mattmonson/OpenSpace/logs/Compression Test/log.csv

time (ms) | temp (C) | pressure (Pa)
1036 | 24.0 | 101054
1320 | 24.0 | 101049
1607 | 24.0 | 101056
1894 | 24.0 | 101044
2179 | 24.0 | 101040
2465 | 24.0 | 101044
2752 | 24.0 | 101054
3037 | 24.0 | 101051
3323 | 24.0 | 101046
3610 | 24.0 | 101044
3895 | 24.0 | 101044
4182 | 24.0 | 101041
4468 | 24.0 | 101042
4753 | 24.0 | 101044
5040 | 24.0 | 101043
5324 | 24.0 | 101044
5611 | 24.0 | 101041
5898 | 24.0 | 101051
6182 | 24.0 | 101041
6469 | 24.0 | 101053
6756 | 24.0 | 101047
7041 | 24.0 | 101053
7327 | 24.0 | 101044
7614 | 24.0 | 101044
7899 | 24.0 | 101056
8185 | 24.0 | 101048
8472 | 24.0 | 101044
8757 | 24.0 | 101049
9043 | 24.0 | 101044
9330 | 24.0 | 101048
9615 | 24.0 | 101049
9902 | 24.0 | 101046
10188 | 24.0 | 101054
10473 | 24.0 | 101042
10760 | 24.0 | 101048
11046 | 24.0 | 101048
11331 | 24.0 | 101054
11618 | 24.0 | 101050
11905 | 24.0 | 101043
12191 | 24.0 | 101047
12476 | 24.0 | 101045
12763 | 24.0 | 101043
13049 | 24.0 | 101050
13334 | 24.0 | 101048
13621 | 24.0 | 101044
13907 | 24.0 | 101042
14194 | 24.0 | 101048
14479 | 24.1 | 101051
14766 | 24.0 | 101046
15052 | 24.0 | 101040
15337 | 24.0 | 101043
15624 | 24.0 | 101043
15910 | 24.0 | 101051
16197 | 24.0 | 101044
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
