mattmonson/OpenSpace/logs/Compression Test/log.xlsx

time (ms) | time (min) | circumference (in) | temp (˚C) | pressure (Pa)
1036 | 0.01726666667 | 0 | 24.0 | 101054
1320 | 0.022 |  | 24.0 | 101049
1607 | 0.02678333333 |  | 24.0 | 101056
1894 | 0.03156666667 |  | 24.0 | 101044
2179 | 0.03631666667 |  | 24.0 | 101040
2465 | 0.04108333333 |  | 24.0 | 101044
2752 | 0.04586666667 |  | 24.0 | 101054
3037 | 0.1 |  | 24.0 | 101051
3323 | 0.1 |  | 24.0 | 101046
3610 | 0.1 |  | 24.0 | 101044
3895 | 0.1 |  | 24.0 | 101044
4182 | 0.1 |  | 24.0 | 101041
4468 | 0.1 |  | 24.0 | 101042
4753 | 0.1 |  | 24.0 | 101044
5040 | 0.1 |  | 24.0 | 101043
5324 | 0.1 |  | 24.0 | 101044
5611 | 0.1 |  | 24.0 | 101041
5898 | 0.1 |  | 24.0 | 101051
6182 | 0.1 |  | 24.0 | 101041
6469 | 0.1 |  | 24.0 | 101053
6756 | 0.1 |  | 24.0 | 101047
7041 | 0.1 |  | 24.0 | 101053
7327 | 0.1 |  | 24.0 | 101044
7614 | 0.1 |  | 24.0 | 101044
7899 | 0.1 |  | 24.0 | 101056
8185 | 0.1 |  | 24.0 | 101048
8472 | 0.1 |  | 24.0 | 101044
8757 | 0.1 |  | 24.0 | 101049
9043 | 0.2 |  | 24.0 | 101044
9330 | 0.2 |  | 24.0 | 101048
9615 | 0.2 |  | 24.0 | 101049
9902 | 0.2 |  | 24.0 | 101046
10188 | 0.2 |  | 24.0 | 101054
10473 | 0.2 |  | 24.0 | 101042
10760 | 0.2 |  | 24.0 | 101048
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
