mattmonson/OpenSpace/boards/Power/TPS6300x/TPS6300x.brd

## EAGLE design boards/Power/TPS6300x/TPS6300x.brd (2012-06-09)

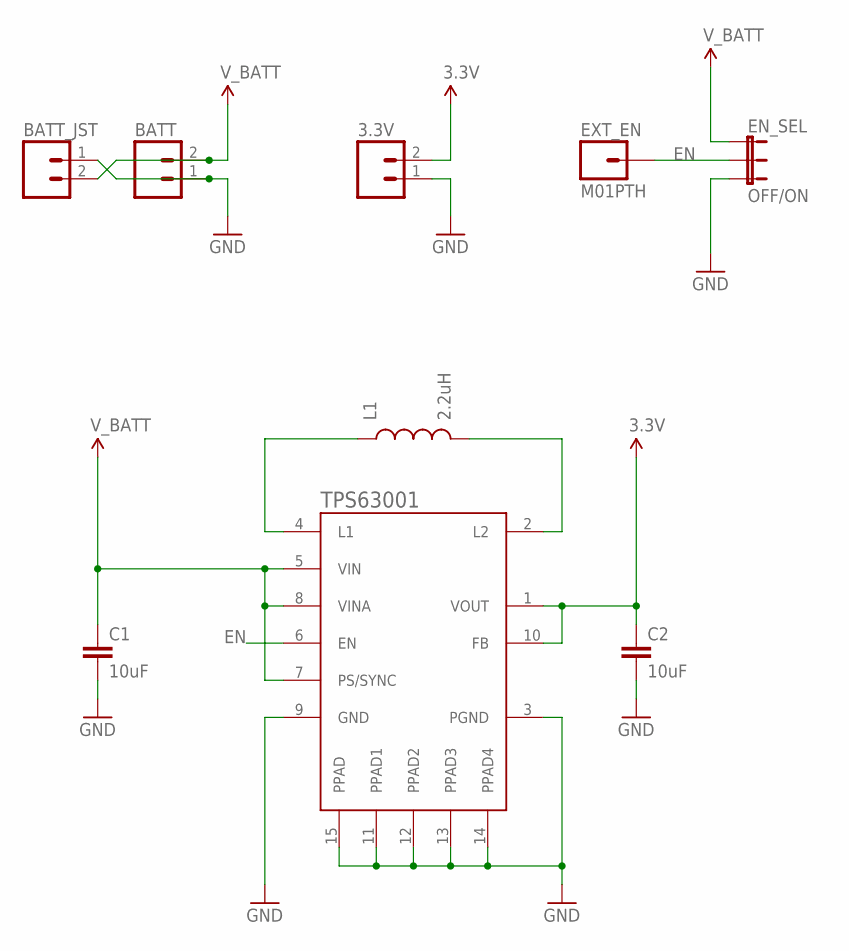
[picture p1: schematic TPS6300x.sch]

Parts:
3.3V: M02PTH; 1X02
BATT: M02PTH; 1X02
BATT_JST: M02-JST-2MM-SMT; JST-2-SMD
C1, C2: 10uF; CAP-2012
EN_SEL: OFF/ON; SJ_3
EXT_EN: M01PTH; 1X01
L1: 2.2uH; INDUCTOR-VLF4012A
TPS63001: TPS6300X; QFN-10_PAD

Connections:
1.8V: BATT.2, BATT_JST.2 (1), C1.+, EN_SEL.1, TPS63001.5 (VIN), TPS63001.7 (PS/SYNC), TPS63001.8 (VINA)
3.3V: 3.3V.2, C2.+, TPS63001.1 (VOUT), TPS63001.10 (FB)
EN: EN_SEL.2, EXT_EN.1, TPS63001.6 (EN)
GND: 3.3V.1, BATT.1, BATT_JST.1 (2), C1.-, C2.-, EN_SEL.3, TPS63001.3 (PGND), TPS63001.9 (GND), TPS63001.11 (PPAD1), TPS63001.12 (PPAD2), TPS63001.13 (PPAD3), TPS63001.14 (PPAD4), TPS63001.15 (PPAD)
unnamed: L1.2, TPS63001.4 (L1)
unnamed: L1.1, TPS63001.2 (L2)

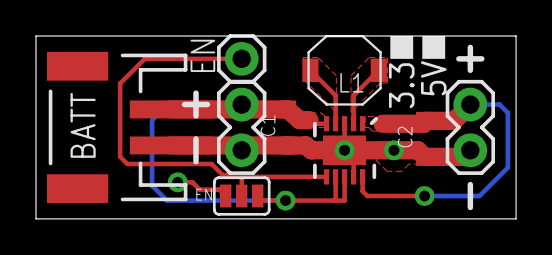
[picture p2: board TPS6300x.brd from above]

Board: 2 copper layers, 26.7 x 10.2 mm, 9 parts (0 on the bottom side), 6 nets.
