mattmonson/OpenSpace/boards/APRS/APRS.brd

## EAGLE design boards/APRS/APRS.brd (2012-06-09)

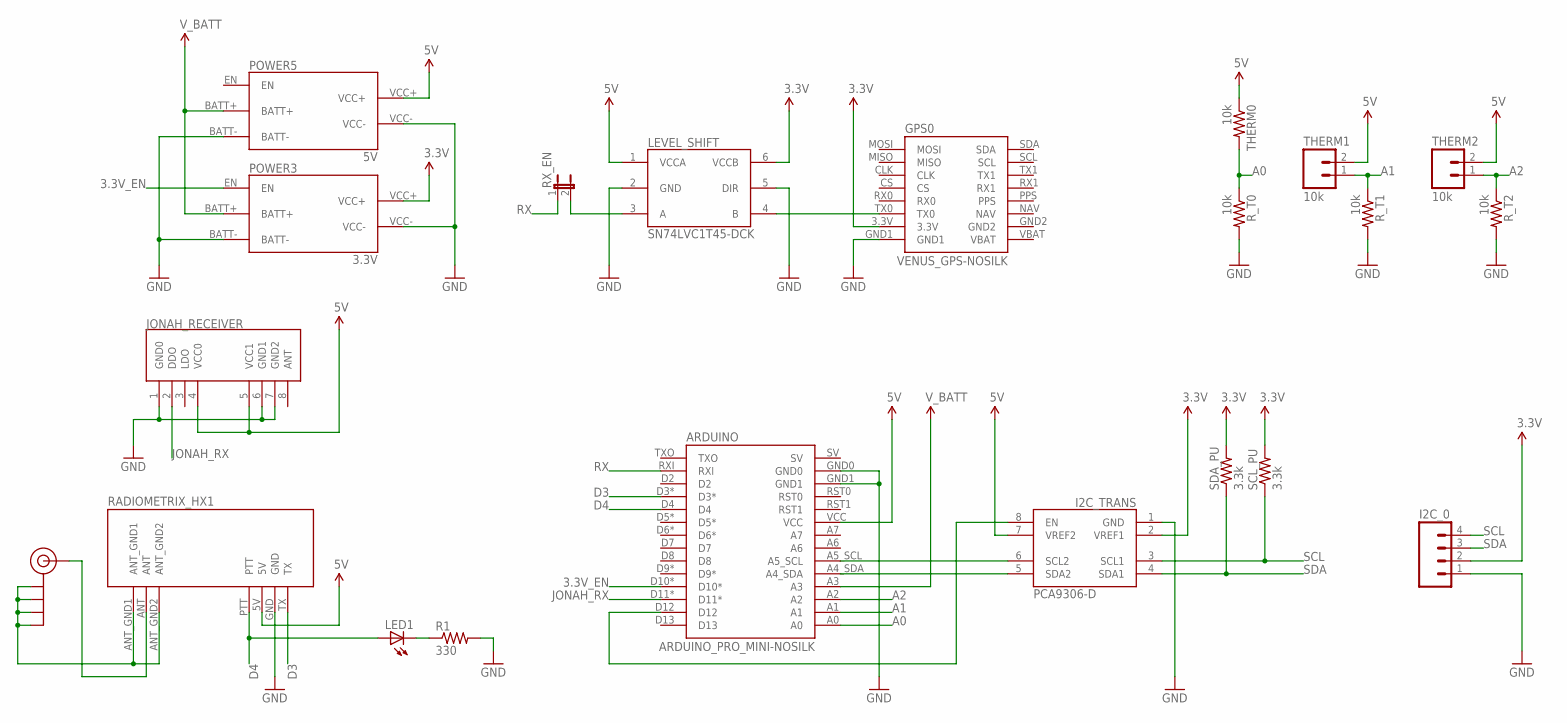
[picture p3: schematic APRS.sch]

Parts:
ARDUINO: ARDUINO_PRO_MINI-NOSILK
GPS0: VENUS_GPS-NOSILK
I2C_0: M04PTH; 1X04
I2C_TRANS: PCA9306-D; SO8
J$1: SMA_EDGE; SMA-EDGE
JONAH_RECEIVER: RADIO-KLP-RECEIVER-NOSILK
LED1: LED0603; LED-0603
LEVEL_SHIFT: SN74LVC1T45-DCK; SC70
POWER3: 3.3V; POWER-TPS6300X-NOSILK
POWER5: 5V; POWER-TPS6300X-NOSILK
R1: 330; 0805
RADIOMETRIX_HX1: RADIOMETRIX-HX1
RX_EN: JUMPER-2PTH; 1X02
R_T0, R_T1, R_T2: 10k; 0805
SCL_PU: 3.3k; 0805
SDA_PU: 3.3k; 0805
THERM0: 10k; 0805
THERM1, THERM2: 10k; JST-2-PTH

Connections:
1.8V: ARDUINO.A3, POWER3.BATT+, POWER5.BATT+
3.3V: GPS0.3.3V, I2C_0.2, I2C_TRANS.2 (VREF1), LEVEL_SHIFT.6 (VCCB), POWER3.VCC+, SCL_PU.2, SDA_PU.2
3.3V_EN: ARDUINO.D10*, POWER3.EN
5V: ARDUINO.VCC, I2C_TRANS.7 (VREF2), JONAH_RECEIVER.4 (VCC0), JONAH_RECEIVER.5 (VCC1), LEVEL_SHIFT.1 (VCCA), POWER5.VCC+, RADIOMETRIX_HX1.5V, THERM0.1, THERM1.2, THERM2.2
A0: ARDUINO.A0, R_T0.1, THERM0.2
A1: ARDUINO.A1, R_T1.1, THERM1.1
A2: ARDUINO.A2, R_T2.1, THERM2.1
D3: ARDUINO.D3*, RADIOMETRIX_HX1.TX
D4: ARDUINO.D4, LED1.A, RADIOMETRIX_HX1.PTT
GND: ARDUINO.GND0, ARDUINO.GND1, GPS0.GND1, I2C_0.1, I2C_TRANS.1 (GND), JONAH_RECEIVER.1 (GND0), JONAH_RECEIVER.6 (GND1), JONAH_RECEIVER.7 (GND2), LEVEL_SHIFT.2 (GND), LEVEL_SHIFT.5 (DIR), POWER3.BATT-, POWER3.VCC-, POWER5.BATT-, POWER5.VCC-, R1.2, RADIOMETRIX_HX1.GND, R_T0.2, R_T1.2, R_T2.2
JONAH_RX: ARDUINO.D11*, JONAH_RECEIVER.2 (DDO)
unnamed: J$1.GND@0 (GND), J$1.GND@1 (GND), J$1.GND@2 (GND), J$1.GND@3 (GND), RADIOMETRIX_HX1.ANT_GND1, RADIOMETRIX_HX1.ANT_GND2
unnamed: J$1.SIG (SIGNAL), RADIOMETRIX_HX1.ANT
unnamed: GPS0.TX0, LEVEL_SHIFT.4 (B)
unnamed: ARDUINO.A4_SDA, I2C_TRANS.5 (SDA2)
unnamed: ARDUINO.A5_SCL, I2C_TRANS.6 (SCL2)
unnamed: ARDUINO.D12, I2C_TRANS.8 (EN)
unnamed: LEVEL_SHIFT.3 (A), RX_EN.2
unnamed: LED1.C, R1.1
RX: ARDUINO.RXI, RX_EN.1
SCL: I2C_0.4, I2C_TRANS.3 (SCL1), SCL_PU.1
SDA: I2C_0.3, I2C_TRANS.4 (SDA1), SDA_PU.1

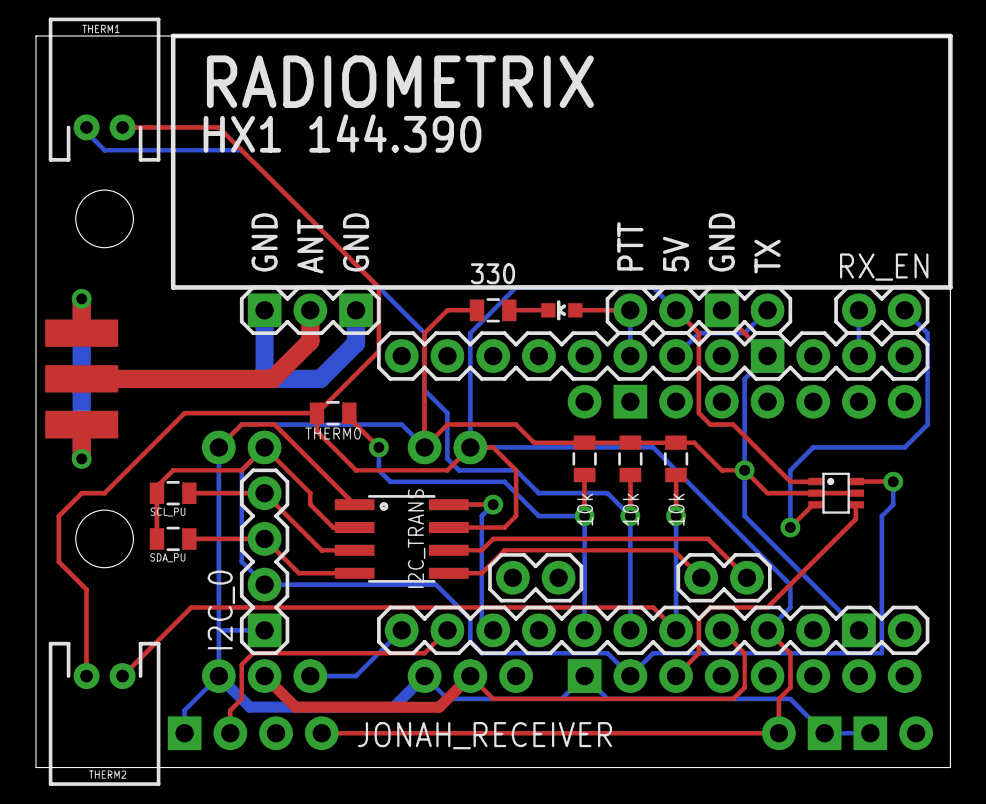
[picture p4: board APRS.brd from above]

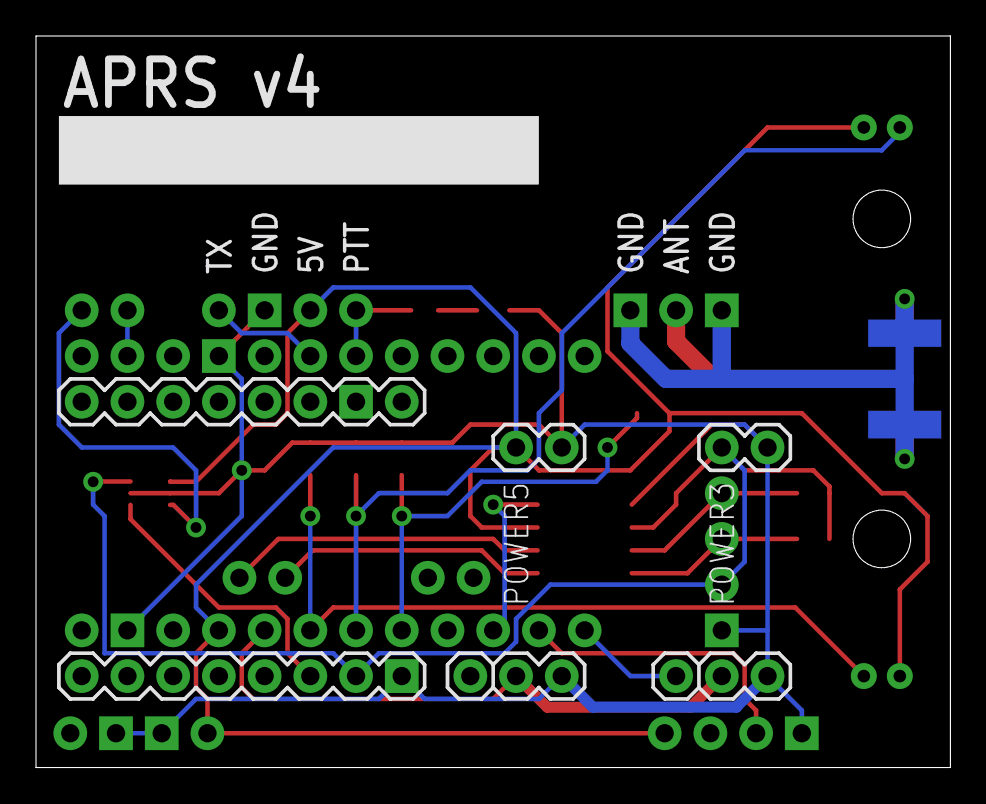
[picture p5: board APRS.brd from below]

Board: 2 copper layers, 50.8 x 40.6 mm, 21 parts (3 on the bottom side), 22 nets.
