mattmonson/OpenSpace/boards/Jonah/Jonah.brd

## EAGLE design boards/Jonah/Jonah.brd (2012-04-29)

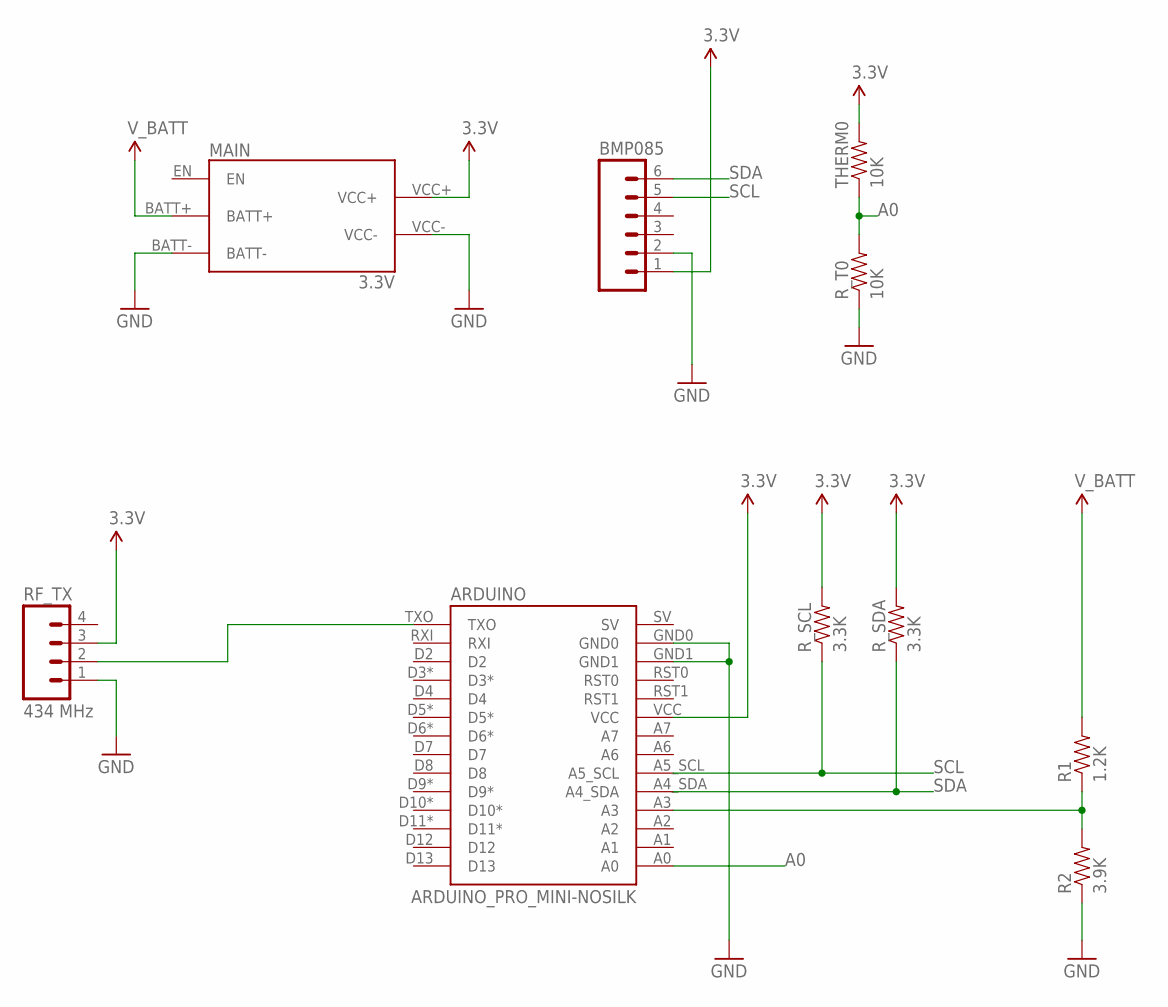
[picture p6: schematic Jonah.sch]

Parts:
ARDUINO: ARDUINO_PRO_MINI-NOSILK
BMP085: M06SIP; 1X06
MAIN: 3.3V; POWER-TPS6300X-NOSILK
R1: 1.2K; 0805
R2: 3.9K; 0805
RF_TX: 434 MHz; 1X04
R_SCL: 3.3K; 0805
R_SDA: 3.3K; 0805
R_T0: 10K; 0805
THERM0: 10K; 0805

Connections:
1.8V: MAIN.BATT+, R1.2
3.3V: ARDUINO.VCC, BMP085.1, MAIN.VCC+, RF_TX.3, R_SCL.2, R_SDA.2, THERM0.2
A0: ARDUINO.A0, R_T0.2, THERM0.1
GND: ARDUINO.GND0, ARDUINO.GND1, BMP085.2, MAIN.BATT-, MAIN.VCC-, R2.1, RF_TX.1, R_T0.1
unnamed: ARDUINO.TXO, RF_TX.2
unnamed: ARDUINO.A3, R1.1, R2.2
SCL: ARDUINO.A5_SCL, BMP085.5, R_SCL.1
SDA: ARDUINO.A4_SDA, BMP085.6, R_SDA.1

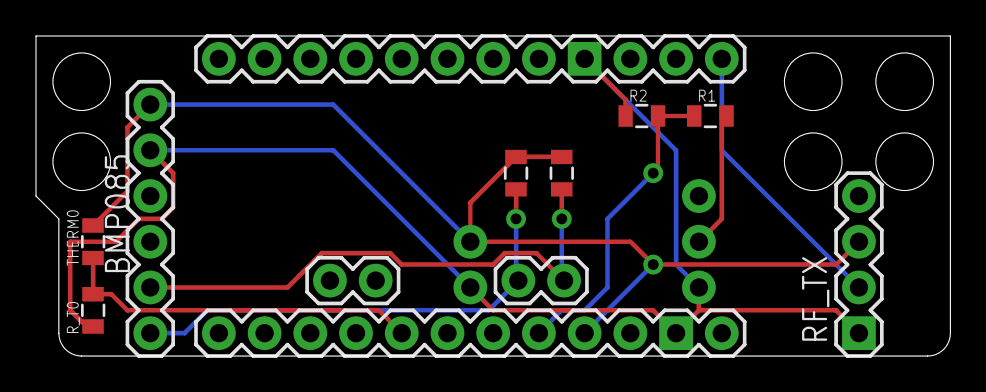
[picture p7: board Jonah.brd from above]

Board: 2 copper layers, 50.8 x 17.8 mm, 10 parts (1 on the bottom side), 8 nets.
