mattmonson/OpenSpace/boards/Balloon/Balloon.brd

## EAGLE design boards/Balloon/Balloon.brd (2012-04-29)

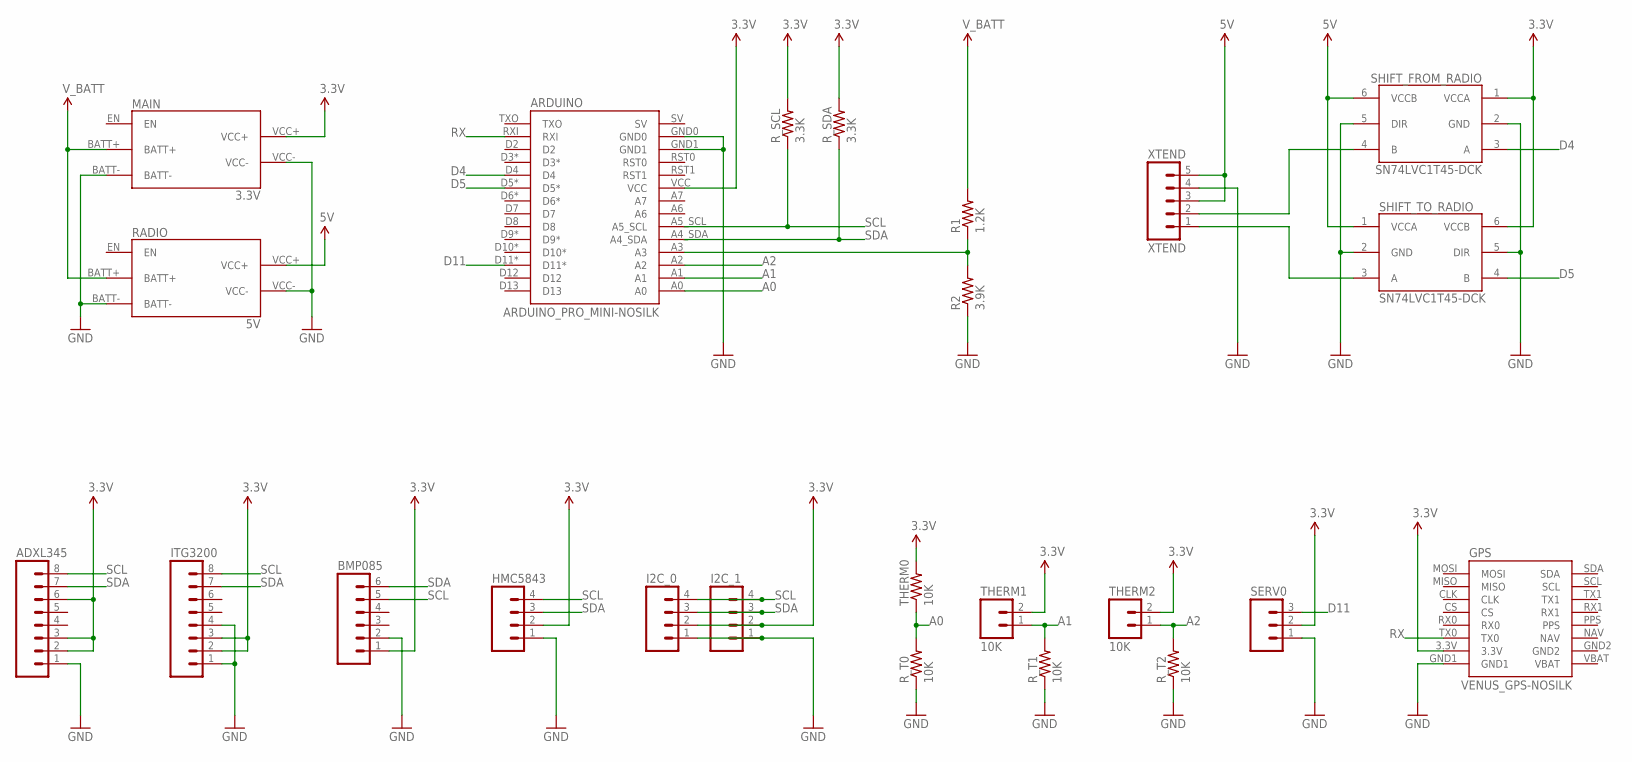
[picture p8: schematic Balloon.sch]

Parts:
ADXL345: M081X08; 1X08
ARDUINO: ARDUINO_PRO_MINI-NOSILK
BMP085: M06SIP; 1X06
GPS: VENUS_GPS-NOSILK
HMC5843: M04PTH; 1X04
I2C_0, I2C_1: M04PTH; 1X04
ITG3200: M081X08; 1X08
MAIN: 3.3V; POWER-TPS6300X-NOSILK
R1: 1.2K; 0805
R2: 3.9K; 0805
RADIO: 5V; POWER-TPS6300X-NOSILK
R_SCL: 3.3K; 0805
R_SDA: 3.3K; 0805
R_T0, R_T1, R_T2: 10K; 0805
SERV0: M03PTH; 1X03
SHIFT_FROM_RADIO: SN74LVC1T45-DCK; SC70
SHIFT_TO_RADIO: SN74LVC1T45-DCK; SC70
THERM0: 10K; 0805
THERM1, THERM2: 10K; JST-2-PTH
XTEND: XTEND; JST-5-PTH-VERT

Connections:
1.8V: MAIN.BATT+, R1.2, RADIO.BATT+
3.3V: ADXL345.2, ADXL345.3, ADXL345.6, ARDUINO.VCC, BMP085.1, GPS.3.3V, HMC5843.2, I2C_0.2, I2C_1.2, ITG3200.2, ITG3200.3, MAIN.VCC+, R_SCL.2, R_SDA.2, SERV0.2, SHIFT_FROM_RADIO.1 (VCCA), SHIFT_TO_RADIO.6 (VCCB), THERM0.2, THERM1.2, THERM2.2
5V: RADIO.VCC+, SHIFT_FROM_RADIO.6 (VCCB), SHIFT_TO_RADIO.1 (VCCA), XTEND.3, XTEND.5
A0: ARDUINO.A0, R_T0.2, THERM0.1
A1: ARDUINO.A1, R_T1.2, THERM1.1
A2: ARDUINO.A2, R_T2.2, THERM2.1
D4: ARDUINO.D4, SHIFT_FROM_RADIO.3 (A)
D5: ARDUINO.D5*, SHIFT_TO_RADIO.4 (B)
D11: ARDUINO.D11*, SERV0.3
GND: ADXL345.1, ARDUINO.GND0, ARDUINO.GND1, BMP085.2, GPS.GND1, HMC5843.1, I2C_0.1, I2C_1.1, ITG3200.1, ITG3200.4, MAIN.BATT-, MAIN.VCC-, R2.1, RADIO.BATT-, RADIO.VCC-, R_T0.1, R_T1.1, R_T2.1, SERV0.1, SHIFT_FROM_RADIO.2 (GND), SHIFT_FROM_RADIO.5 (DIR), SHIFT_TO_RADIO.2 (GND), SHIFT_TO_RADIO.5 (DIR), XTEND.4
unnamed: SHIFT_FROM_RADIO.4 (B), XTEND.2
unnamed: ARDUINO.A3, R1.1, R2.2
unnamed: SHIFT_TO_RADIO.3 (A), XTEND.1
RX: ARDUINO.RXI, GPS.TX0
SCL: ADXL345.8, ARDUINO.A5_SCL, BMP085.5, HMC5843.4, I2C_0.4, I2C_1.4, ITG3200.8, R_SCL.1
SDA: ADXL345.7, ARDUINO.A4_SDA, BMP085.6, HMC5843.3, I2C_0.3, I2C_1.3, ITG3200.7, R_SDA.1

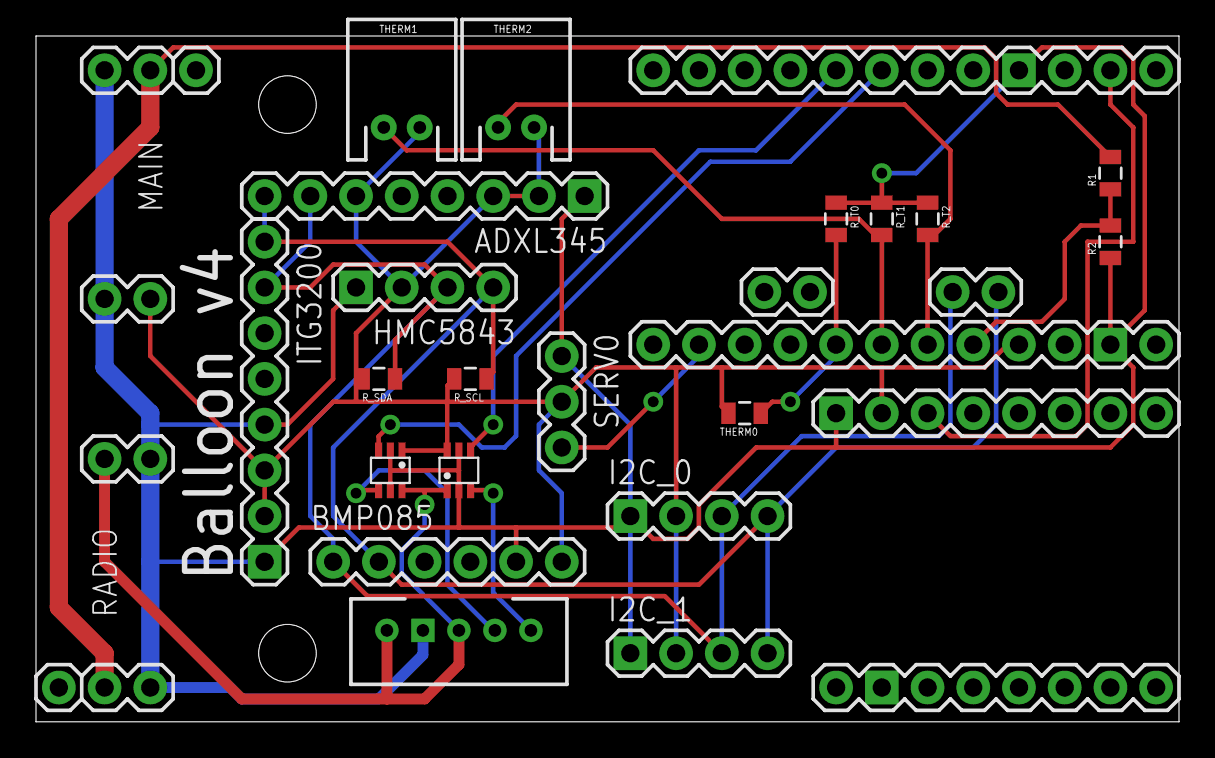
[picture p9: board Balloon.brd from above]

Board: 2 copper layers, 63.5 x 38.1 mm, 24 parts (0 on the bottom side), 16 nets.
