mattmonson/OpenSpace/boards/Level Shift Breakout/Level Shift Breakout.brd

## EAGLE design boards/Level Shift Breakout/Level Shift Breakout.brd (2012-04-02)

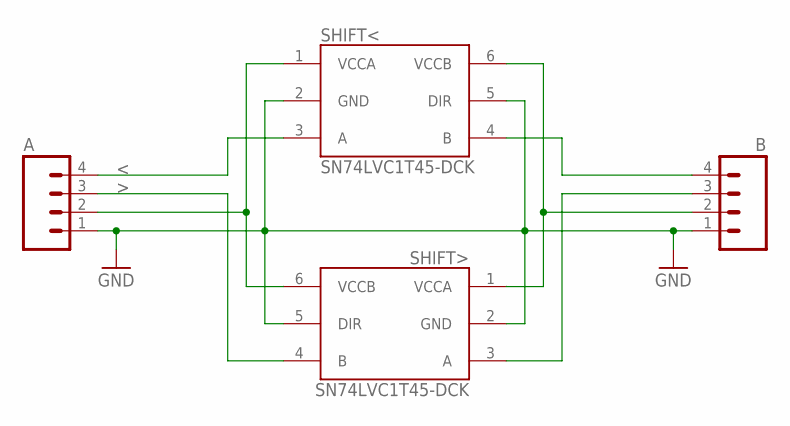
[picture p10: schematic Level Shift Breakout.sch]

Parts:
A: M04PTH; 1X04
B: M04PTH; 1X04
SHIFT<: SN74LVC1T45-DCK; SC70
SHIFT>: SN74LVC1T45-DCK; SC70

Connections:
<: A.4, SHIFT<.3 (A)
>: A.3, SHIFT>.4 (B)
GND: A.1, B.1, SHIFT<.2 (GND), SHIFT<.5 (DIR), SHIFT>.2 (GND), SHIFT>.5 (DIR)
unnamed: B.4, SHIFT<.4 (B)
unnamed: A.2, SHIFT<.1 (VCCA), SHIFT>.6 (VCCB)
unnamed: B.2, SHIFT<.6 (VCCB), SHIFT>.1 (VCCA)
unnamed: B.3, SHIFT>.3 (A)

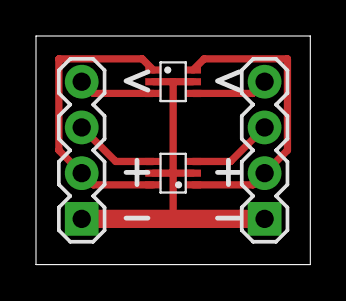
[picture p11: board Level Shift Breakout.brd from above]

Board: 2 copper layers, 15.2 x 12.7 mm, 4 parts (0 on the bottom side), 7 nets.
