mattmonson/OpenSpace/boards/Power/LM2623/LM2623.brd

## EAGLE design boards/Power/LM2623/LM2623.brd (2012-04-02)

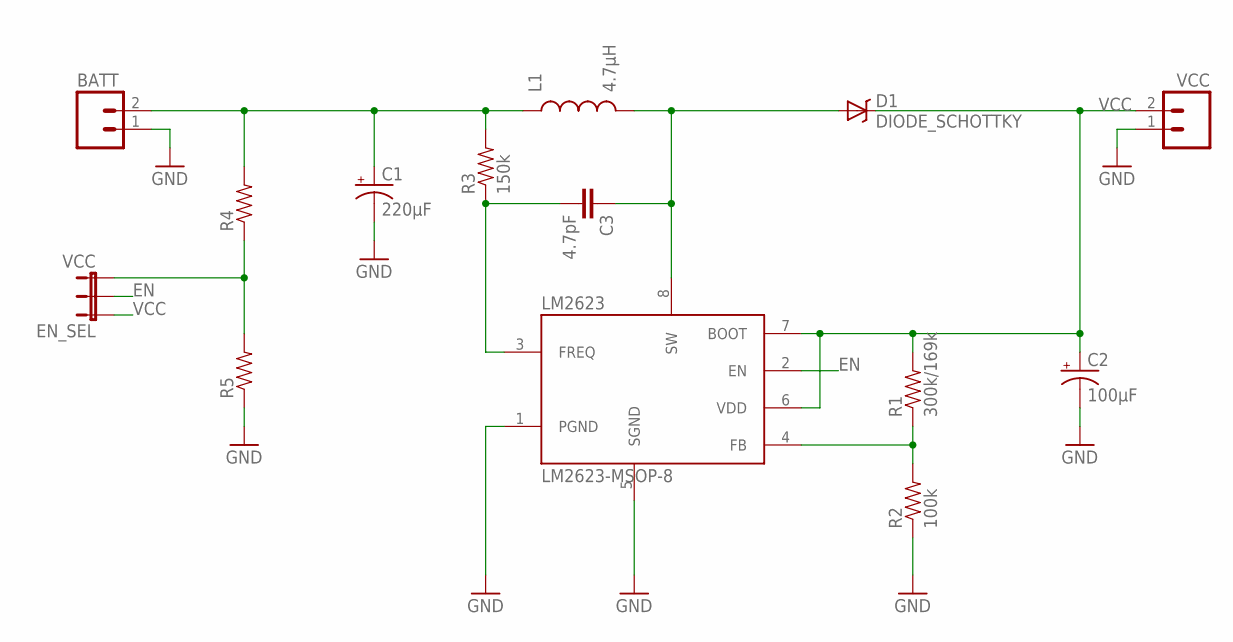
[picture p12: schematic LM2623.sch]

Parts:
BATT: M02PTH; 1X02
C1: 220µF; EIA3528
C2: 100µF; EIA3528
C3: 4.7pF; 0603-CAP
D1: DIODE_SCHOTTKY; DO-214AB
EN_SEL: VCC; SJ_3
L1: 4.7µH; INDUCTOR_SRR7032
LM2623: LM2623-MSOP-8; MSOP-8
R1: 300k/169k; 0805
R2: 100k; 0805
R3: 150k; 0805
R4, R5: RESISTOR0805-RES; 0805
VCC: M02PTH; 1X02

Connections:
EN: EN_SEL.2, LM2623.2 (EN)
GND: BATT.1, C1.C (-), C2.C (-), LM2623.1 (PGND), LM2623.5 (SGND), R2.1, R5.1, VCC.1
unnamed: C3.2, LM2623.3 (FREQ), R3.1
unnamed: C3.1, D1.A, L1.1, LM2623.8 (SW)
unnamed: EN_SEL.3, R4.1, R5.2
unnamed: LM2623.4 (FB), R1.1, R2.2
VBAT: BATT.2, C1.A (+), L1.2, R3.2, R4.2
VCC: C2.A (+), D1.C, EN_SEL.1, LM2623.6 (VDD), LM2623.7 (BOOT), R1.2, VCC.2

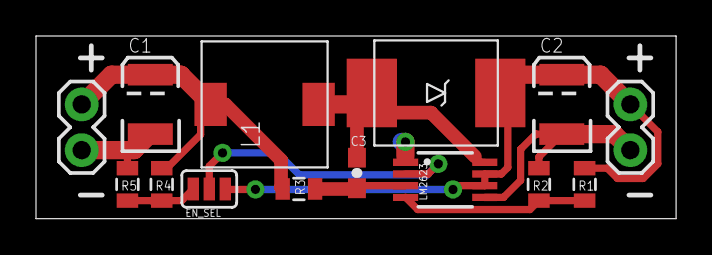
[picture p13: board LM2623.brd from above]

Board: 2 copper layers, 35.6 x 10.2 mm, 14 parts (0 on the bottom side), 8 nets.
