mattmonson/OpenSpace/boards/Power/LM2623+TPS54386/FullPower.brd

## EAGLE design boards/Power/LM2623+TPS54386/FullPower.brd (2012-04-02)

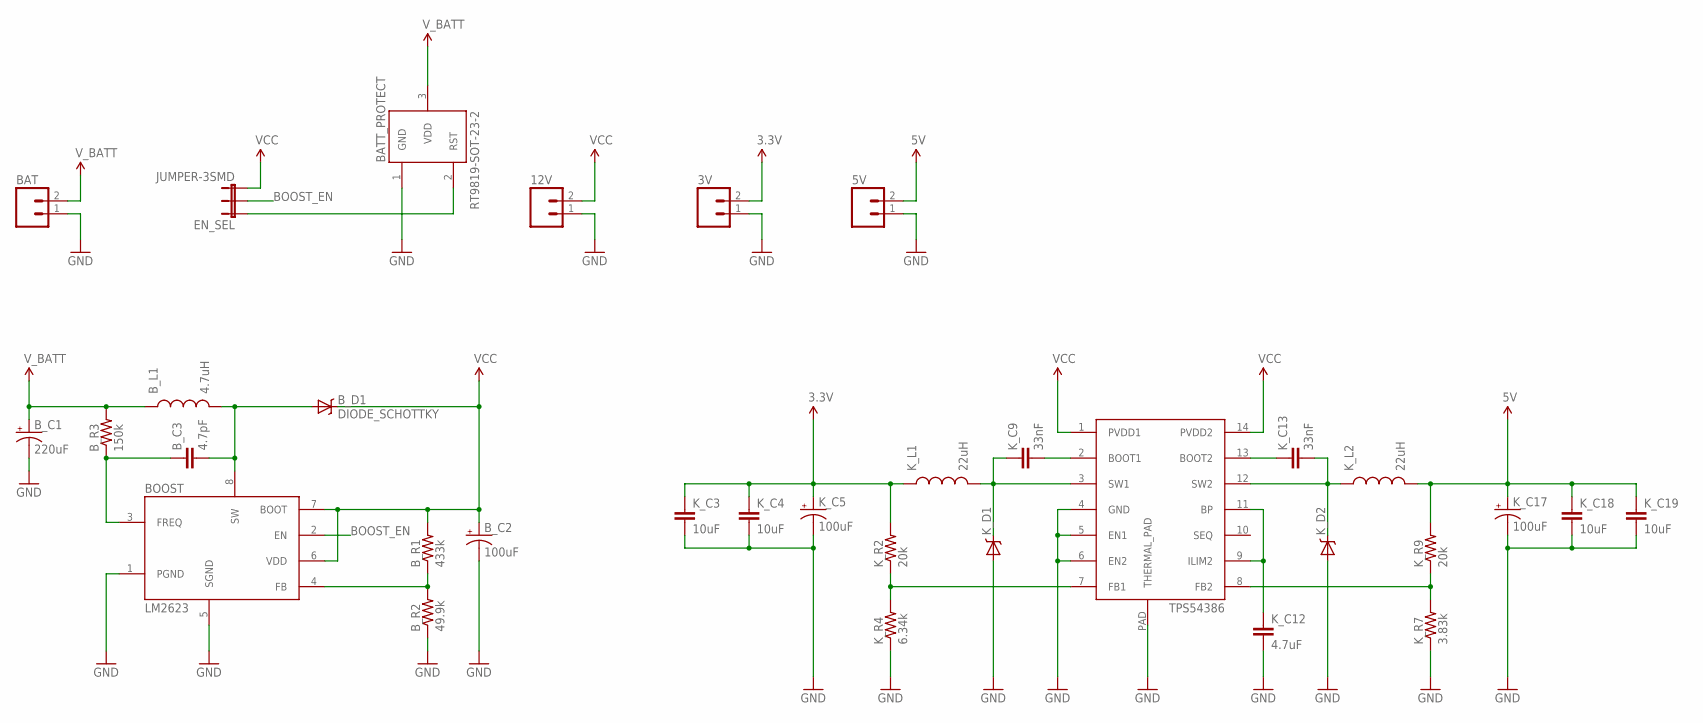
[picture p14: schematic FullPower.sch]

Parts:
3V, 5V, 12V: M02PTH; 1X02
BAT: M02PTH; 1X02
BATT_PROTECT: RT9819-SOT-23-2; SOT-23-2
BOOST: LM2623; MSOP-8
BUCK: TPS54386; HTSSOP-14
B_C1: 220uF; EIA3528
B_C2: 100uF; EIA7343
B_C3: 4.7pF; CAP-1608
B_D1: DIODE_SCHOTTKY; DO-214AB
B_L1: 4.7uH; INDUCTOR_SRR7032
B_R1: 433k; 0805
B_R2: 49.9k; 0805
B_R3: 150k; 0805
EN_SEL: JUMPER-3SMD; SJ_3
K_C3, K_C4, K_C18, K_C19: 10uF; CAP-2012
K_C5, K_C17: 100uF; PANASONIC-F
K_C9, K_C13: 33nF; CAP-1608
K_C12: 4.7uF; CAP-2012
K_D1, K_D2: DIODE_SCHOTTKY; DO-214AB
K_L1, K_L2: 22uH; INDUCTOR-PF0560NL
K_R2, K_R9: 20k; 0805
K_R4: 6.34k; 0805
K_R7: 3.83k; 0805

Connections:
1.8V: BAT.2, BATT_PROTECT.3 (VDD), B_C1.A (+), B_L1.2, B_R3.2
3.3V: 3V.2, K_C3.+, K_C4.+, K_C5.+, K_L1.2, K_R2.2
5V: 5V.2, K_C17.+, K_C18.+, K_C19.+, K_L2.1, K_R9.2
BOOST_EN: BOOST.2 (EN), EN_SEL.2
GND: 3V.1, 5V.1, 12V.1, BAT.1, BATT_PROTECT.1 (GND), BOOST.1 (PGND), BOOST.5 (SGND), BUCK.4 (GND), BUCK.5 (EN1), BUCK.6 (EN2), BUCK.PAD (THERMAL_PAD), B_C1.C (-), B_C2.C (-), B_R2.1, K_C3.-, K_C4.-, K_C5.-, K_C12.-, K_C17.-, K_C18.-, K_C19.-, K_D1.A, K_D2.A, K_R4.1, K_R7.1
unnamed: BOOST.4 (FB), B_R1.1, B_R2.2
unnamed: BUCK.3 (SW1), K_C9.+, K_D1.C, K_L1.1
unnamed: BUCK.12 (SW2), K_C13.-, K_D2.C, K_L2.2
unnamed: BOOST.8 (SW), B_C3.-, B_D1.A, B_L1.1
unnamed: BOOST.3 (FREQ), B_C3.+, B_R3.1
unnamed: BUCK.7 (FB1), K_R2.1, K_R4.2
unnamed: BUCK.8 (FB2), K_R7.2, K_R9.1
unnamed: BUCK.9 (ILIM2), BUCK.11 (BP), K_C12.+
unnamed: BUCK.2 (BOOT1), K_C9.-
unnamed: BUCK.13 (BOOT2), K_C13.+
unnamed: BATT_PROTECT.2 (RST), EN_SEL.1
VCC: 12V.2, BOOST.6 (VDD), BOOST.7 (BOOT), BUCK.1 (PVDD1), BUCK.14 (PVDD2), B_C2.A (+), B_D1.C, B_R1.2, EN_SEL.3

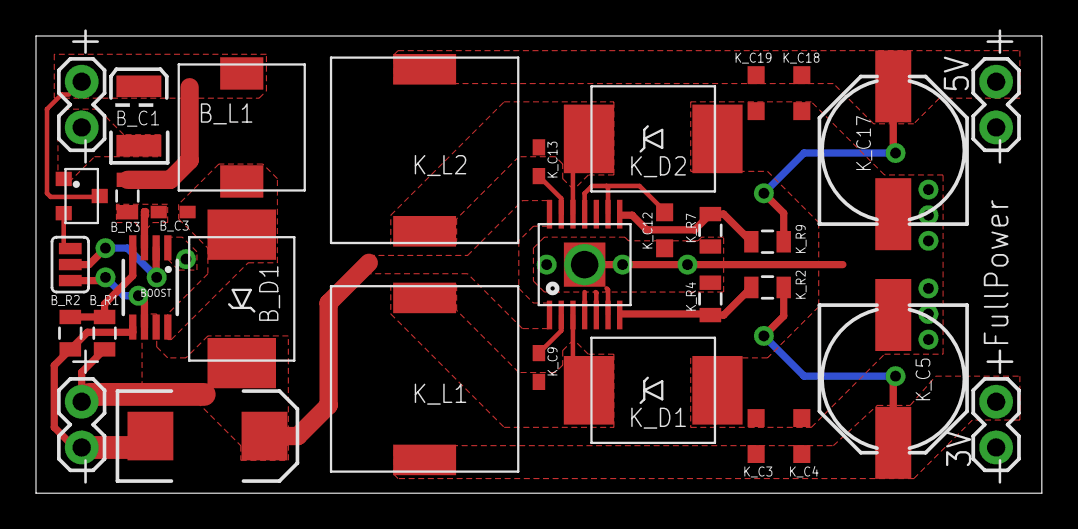
[picture p15: board FullPower.brd from above]

Board: 2 copper layers, 55.9 x 25.4 mm, 33 parts (0 on the bottom side), 17 nets.
