mattmonson/OpenSpace/(commit log)

2012-04-02 Import (without history =/ ) from my personal projects
    [APRS.brd, APRS.sch, Balloon.brd, Balloon.csv, Balloon.sch, Balloon.xlsx, CONFIG.txt, DrivingToTheLaunchPoint.csv]
2012-04-02 Convert .pde's to .ino's
    This is the first step in the process of moving to Arduino 1.0
2012-04-02 Add *.swp to .gitignore (Arduino temp file)
2012-04-02 Changes to get APRS compiling under Arduino 1.0
2012-04-02 Fix compile warnings in APRS under Arduino 1.0
    [APRS.ino]
2012-04-02 Get Balloon.ino building under Arduino 1.0
2012-04-02 BalloonTracker building under Arduino 1.0
2012-04-04 Added modified twi.h/.c for Arduno 1.0
    The changes from the 'normal' twi.h/.c allow for timeouts
    in the case where the I2C hardware thinks it sees another
    master talking on the line (and loses the arbitration).
    Without these changes, if there's ever a hiccup on the
    line, the Arduino just gets stuck forever.
    See: http://www.arduino.cc/cgi-bin/yabb2/YaBB.pl?num=1283887406
2012-04-05 Switch to using standard types
    uint8_t instead of u8
    int32_t instead of s32
    etc
2012-04-06 Replace TinyGPS::get_has_fix with bool returns on get_position and get_datetime
    Also added some pointer checks in f_get_position to match get_position.
    [APRS.ino, Balloon.ino, BalloonTracker.ino, Packets.h]
2012-04-09 Minor edits to the TPS6300x board and its library footprint
    - Added external enable pin (might want this for APRS 3.3v)
    - Fixed text issues with the footprint (didn't add EN yet)
    [TPS6300x.brd, TPS6300x.sch]
2012-04-10 Remove old power datasheet, add new one for TPS6300x
2012-04-15 TPS6300x v2
    - Resistor dividor is now for the UVLO (Vina) pin, not EN
    - EN is broken out so we can drive it externally
    - Added SMD jumpers for UVLO and EN select
    [TPS6300x.brd, TPS6300x.sch]
2012-04-16 First pass of APRS v2
    - Cleaned up the board (removed unnecessary things)
    - Switched to using more library objects
    - Switched to TPS6300x for power
    - Integrated the Venus GPS
    [APRS.brd, APRS.sch]
2012-04-17 Added NOSILK variants for the power board and the ArduinoProMini
    Also added A6 and A7 for the Pro Mini
2012-04-17 Added NOSILK variant of the TPS6300x power board
2012-04-19 New APRS board, close to ready
    [APRS.brd, APRS.sch]
2012-04-19 Balloon board updated with new power boards and library components
    [Balloon.brd, Balloon.sch]
2012-04-23 APRS v2 as submitted to manufacturing
    [APRS.brd]
2012-04-23 Ballon v4 as submitted to manufacturing
    [Balloon.brd, Balloon.sch]
2012-04-23 Jonah (belly of the balloon computer) v1 as manufactured
    [Jonah.brd, Jonah.sch]
2012-04-26 First pass at Jonah board v2
    [Jonah.brd, Jonah.sch]
2012-04-29 First pass at Jonah app
    Jonah is basically a little computer that we can put up inside
    the balloon. It will measure the balloon's internal pressure and
    temperature, and send it back to the main payload computer(s) via
    radio.
2012-04-29 Successfull transmissions from Jonah to APRS
    This change demonstrates the ability to send packets from the Jonah
    sensor package to the APRS computer. It is by no means done yet, but
    it's working decently well.
2012-04-29 Added Jonah receiver to APRS v3
    [APRS.brd, APRS.sch]
2012-04-29 Minor position changes on the Balloon board
    [Balloon.brd]
2012-04-29 Jonah board v2
    Rearranged things, and now use SparkFun's KLP radio, not an Xbee.
    Also, made some space and holes for attaching to a rod.
    [Jonah.brd, Jonah.sch]
2012-05-08 Logs from the compression test
    We filled a balloon with compressed air, and measured what the
    interior pressure did as the volume increased.
    [log.csv, log.xlsx]
2012-05-10 TPS6300x v3 as manufactured
    Just added checkboxes on the bottom for 3.3V vs 5V
    [TPS6300x.brd]
2012-05-12 Get APRS working with the new layout
    Also saved some memory (mostly from const strings),
    because I was running out and crashing =/
    [APRS.ino, Jonah.cpp]
2012-05-18 Removed voltage divider on power board
    Vina wasn't the place to do a voltage divider, and I realized that I
    really didn't need one -- I don't want a cutoff for the Lithium primary
    batteries, and the Li-Ion batteries have a built-in low-voltage cutoff.
    [TPS6300x.brd, TPS6300x.sch]
2012-05-18 Fixed misnamed I2C pull-ups
    [APRS.brd, APRS.sch]
2012-05-18 Add pressure sensor to APRS
2012-06-09 APRS v4 -- Added RX_EN
    I couldn't solder the Arduino board directly because the level
    shifter was breaking uploading sketches, so I added an RX_EN
    jumper.
    [APRS.brd, APRS.sch]
2012-06-09 TPS6300x v4 -- Added 3.3/5V checkboxes on top
    [TPS6300x.brd]
2012-06-10 Have Jonah transmit continuously instead of at 1Hz
2012-06-11 Jonah data integrity check now uses CRC32
    Used to be just a stupid checksum, but that failed
    to catch errrors too frequently.
    [APRS.ino, Jonah.cpp, Jonah.h, Jonah.ino]
2012-06-12 Fix JonahRX's influence on other components
    Now we only run JonahRX every few seconds (and turn it off after a
    timeout or a successful packet) because it screws with other systems
    when it's running.
    SoftwareSerial does some magic with interrupts that can break other
    systems if it's running all the time.
    [APRS.ino]
2012-06-17 Changed the led blinking math
2012-06-17 Fix Jonah timeout logic and add to status LED
    There wasn't timeout logic in the Jonah receive while() loop, which was
    often where we'd get bogged down.
    Also, tweaked the normal LED blinking logic, and added another blink
    every time we receive a Jonah packet so that we can visually inspect and
    make sure we're receiving data correctly from Jonah.
    [APRS.ino]
2012-06-30 Set Balloon TX interval to 1s for battery life
2012-07-01 Transmit BMP pressure over the XTend radio
2012-12-05 Track Jonah packet loss
2012-12-05 Switched tabs to spaces
2012-12-06 Reduced APRS memory usage
    Switched to sprintf_P from sprintf so that the format strings only take
    up program memory.
    Also reduced the size allotted to the MicE string, because it's only
    using 14 bytes anyway.
    And added memory output after printing the APRS string to stay on top of
    things.
2012-12-23 Transmit faster as we descend and get close
    Define a different transmit period when descending (< -1.5m/s), once we
    get close enough (< 3,000m) to the ground.
